Furrah/Bat_detector_FW/bat_detector_circuit.pdf

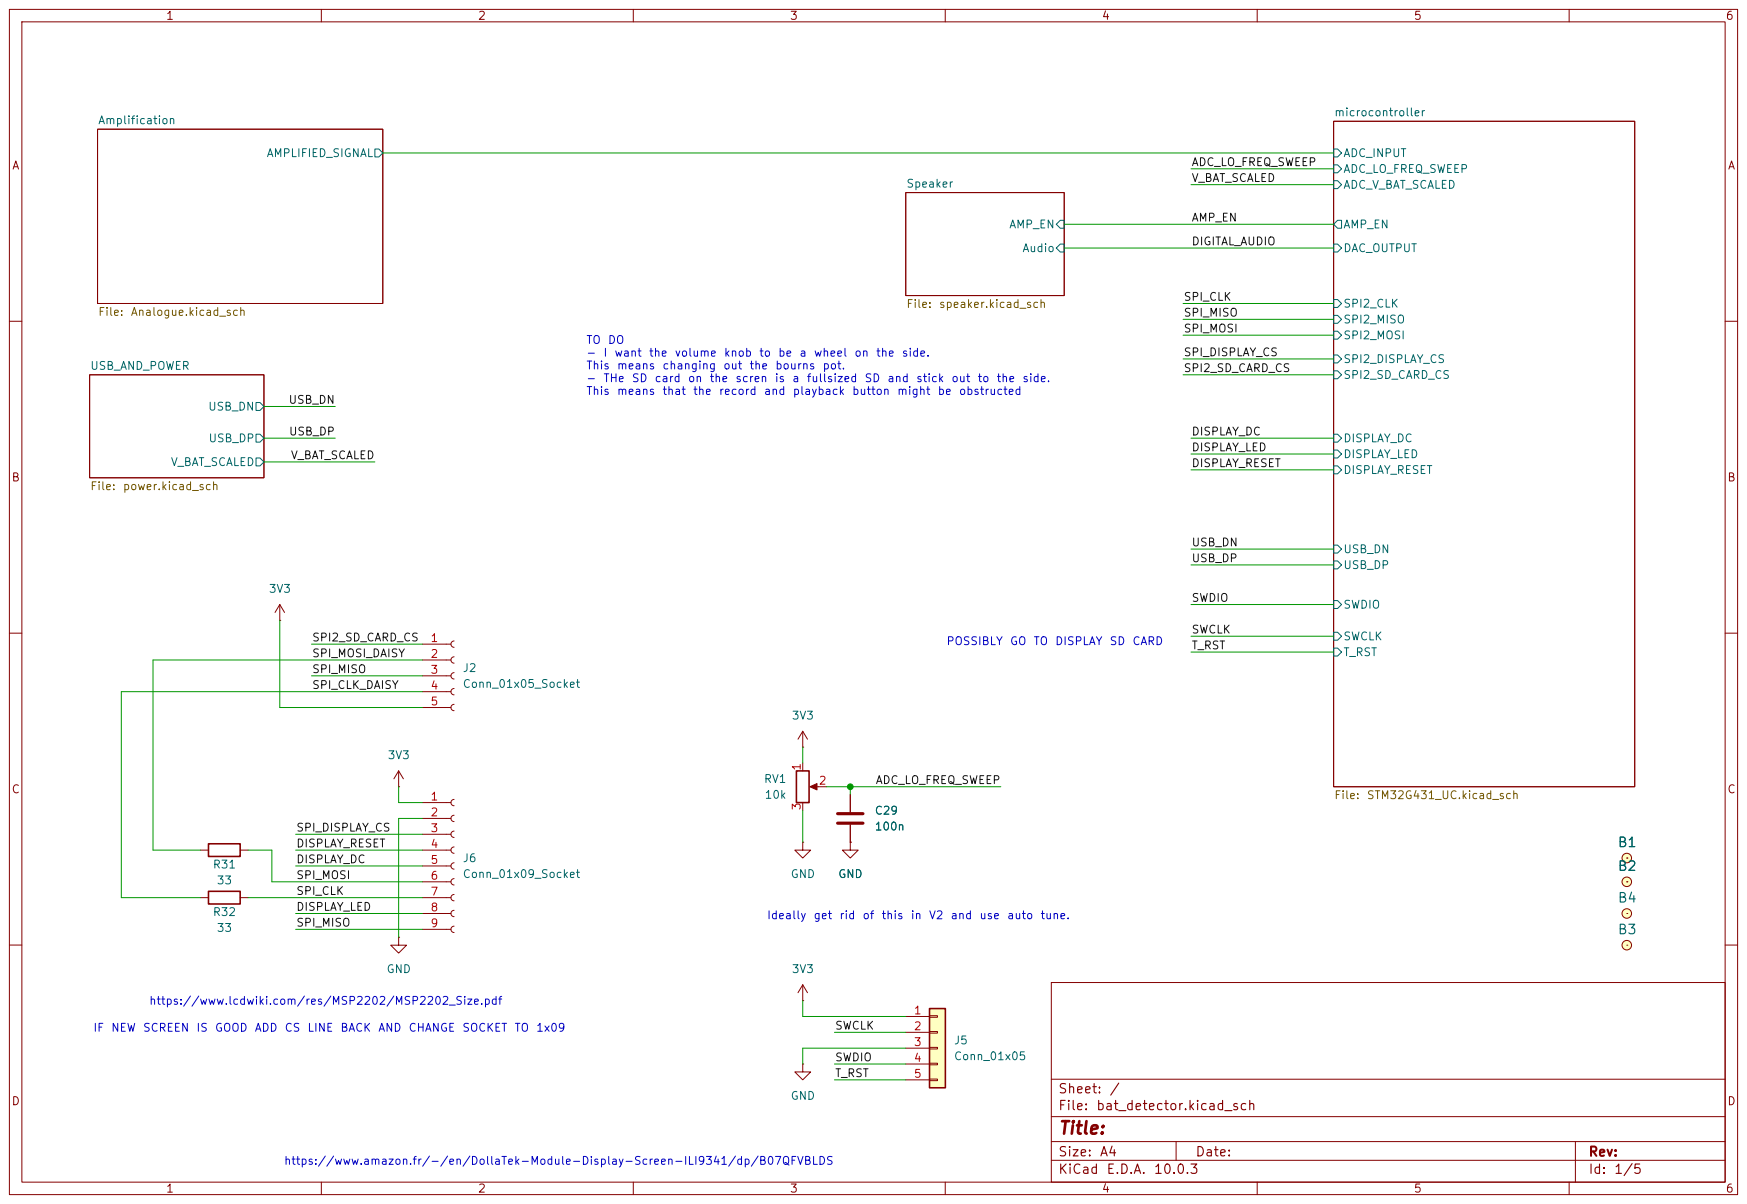
[picture p1: page 1]

TO DO - I want the volume knob to be a wheel on the side.

This means changing out the bourns pot. - THe SD card on the scren is a fullsized SD and stick out to the side.

Ideally get rid of this in V2 and use auto tune. POSSIBLY GO TO DISPLAY SD CARD

https://www.lcdwiki.com/res/MSP2202/MSP2202_Size.pdf

IF NEW SCREEN IS GOOD ADD CS LINE BACK AND CHANGE SOCKET TO 1x09

Size: A4 | Rev:
KiCad E.D.A. 10.0.3 | Id: 1/5

https://www.amazon.fr/-/en/DollaTek-Module-Display-Screen-ILI9341/dp/B07QFVBLDS

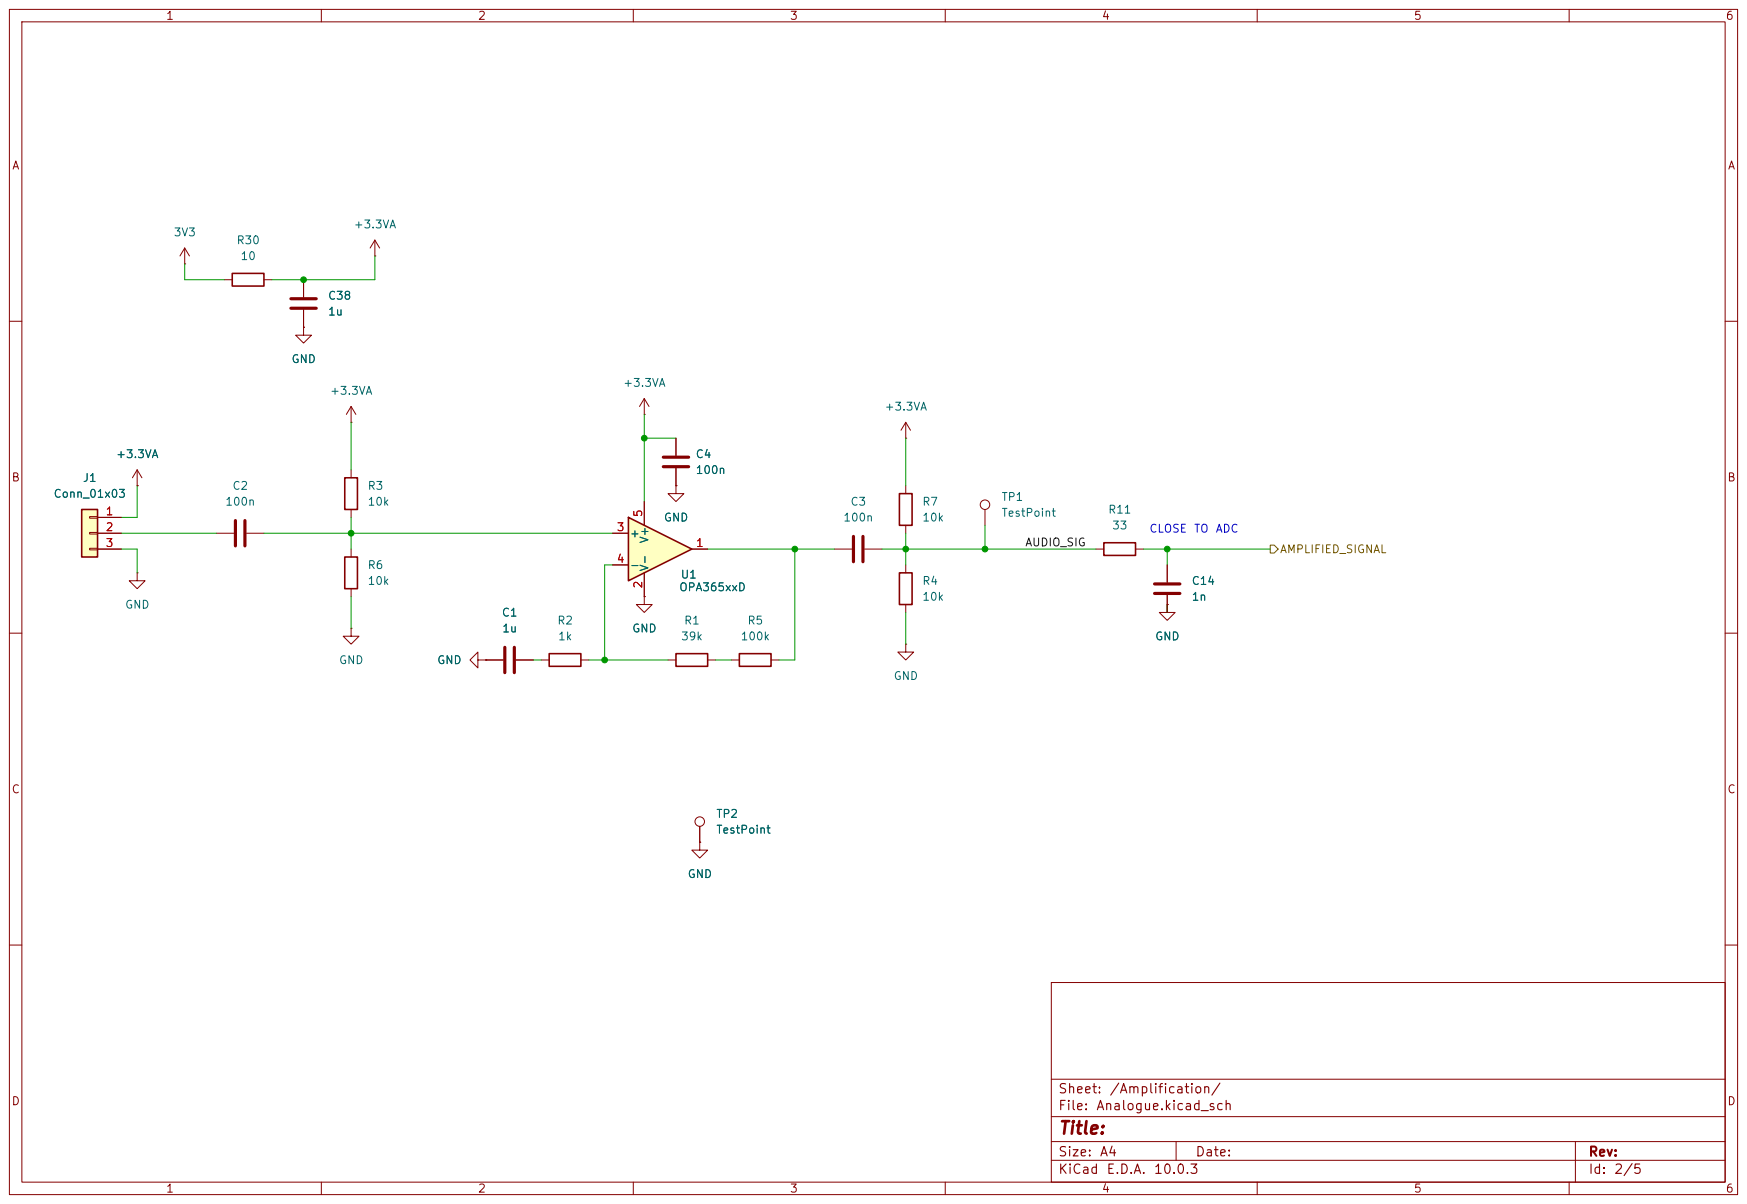
[picture p2: page 2]

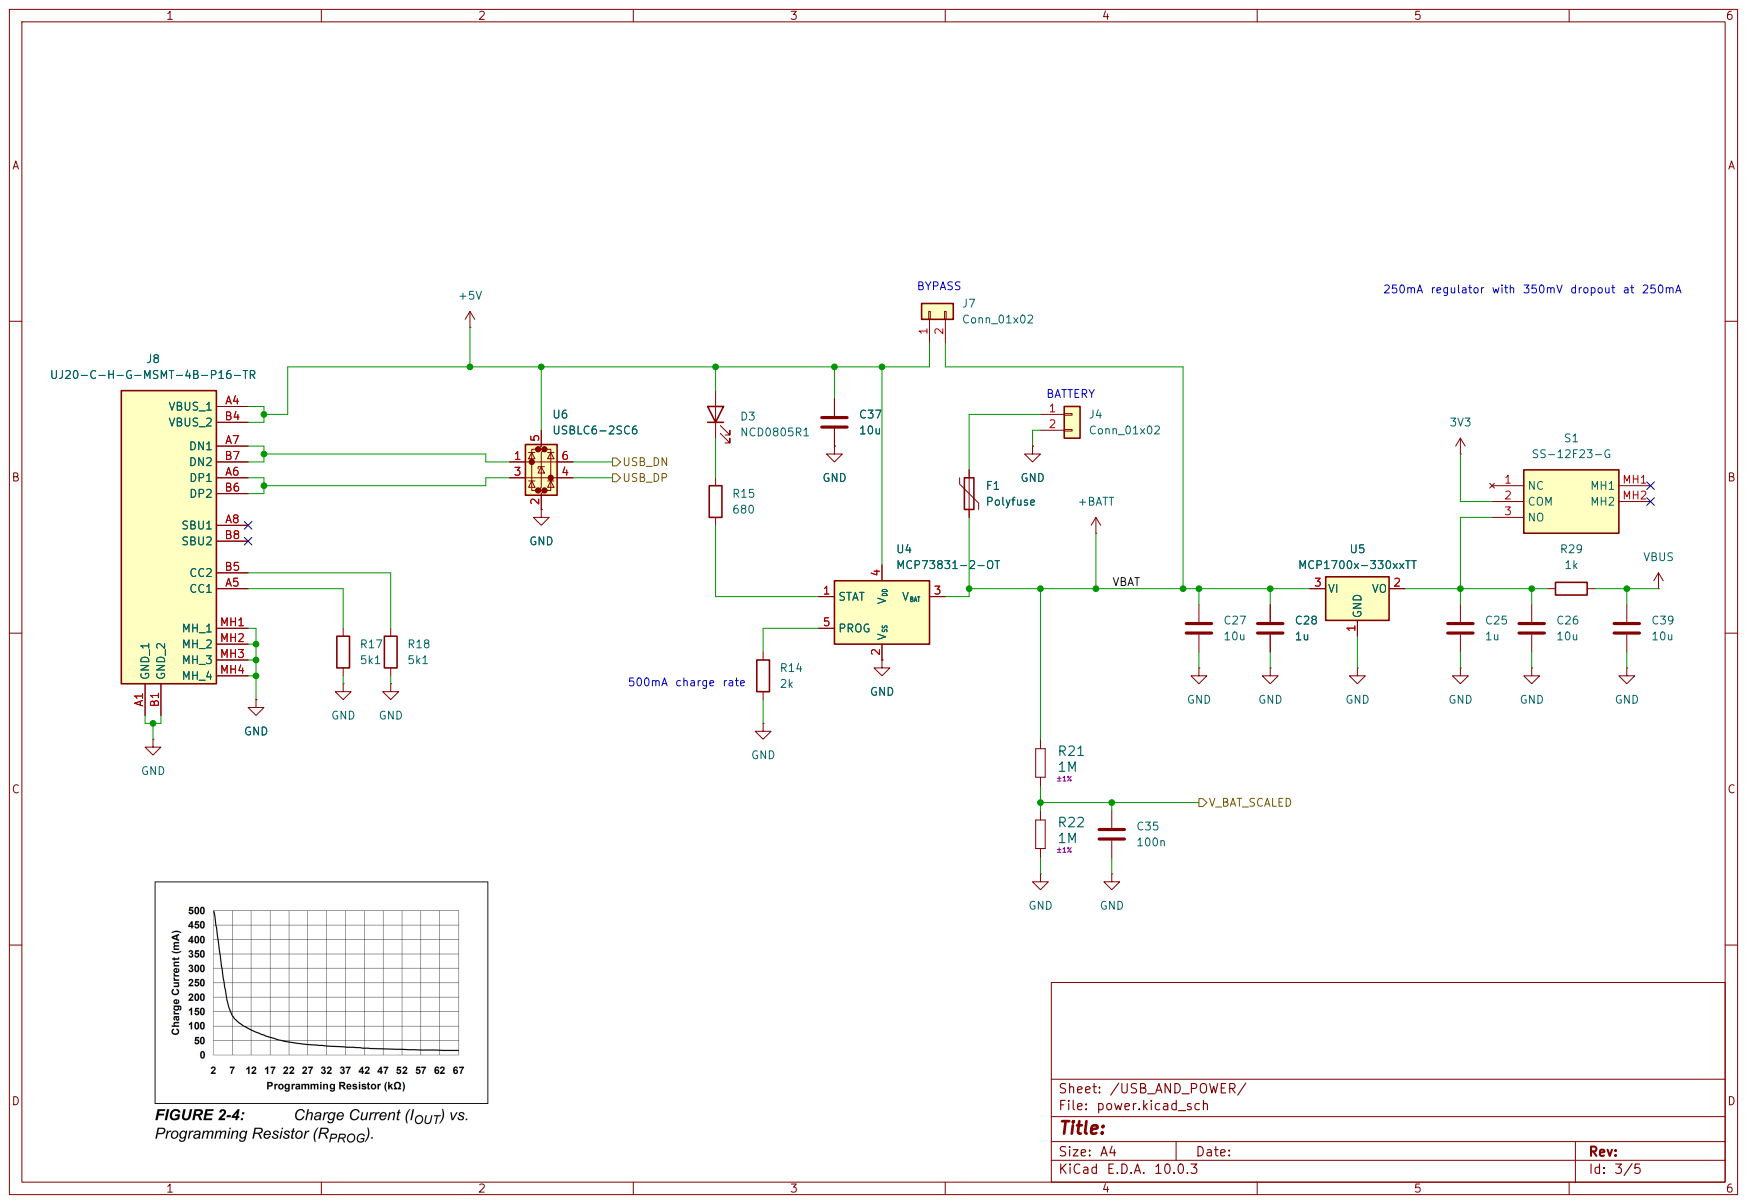
[picture p3: page 3]

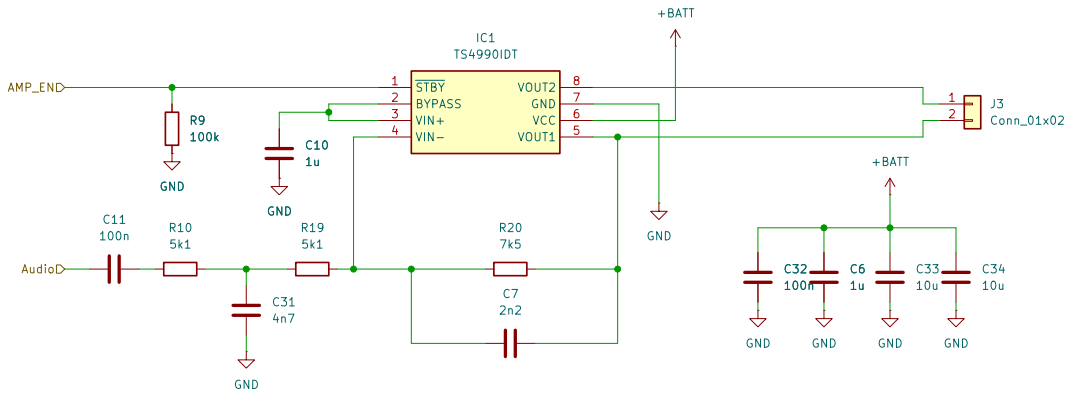
[picture p4: page 4]

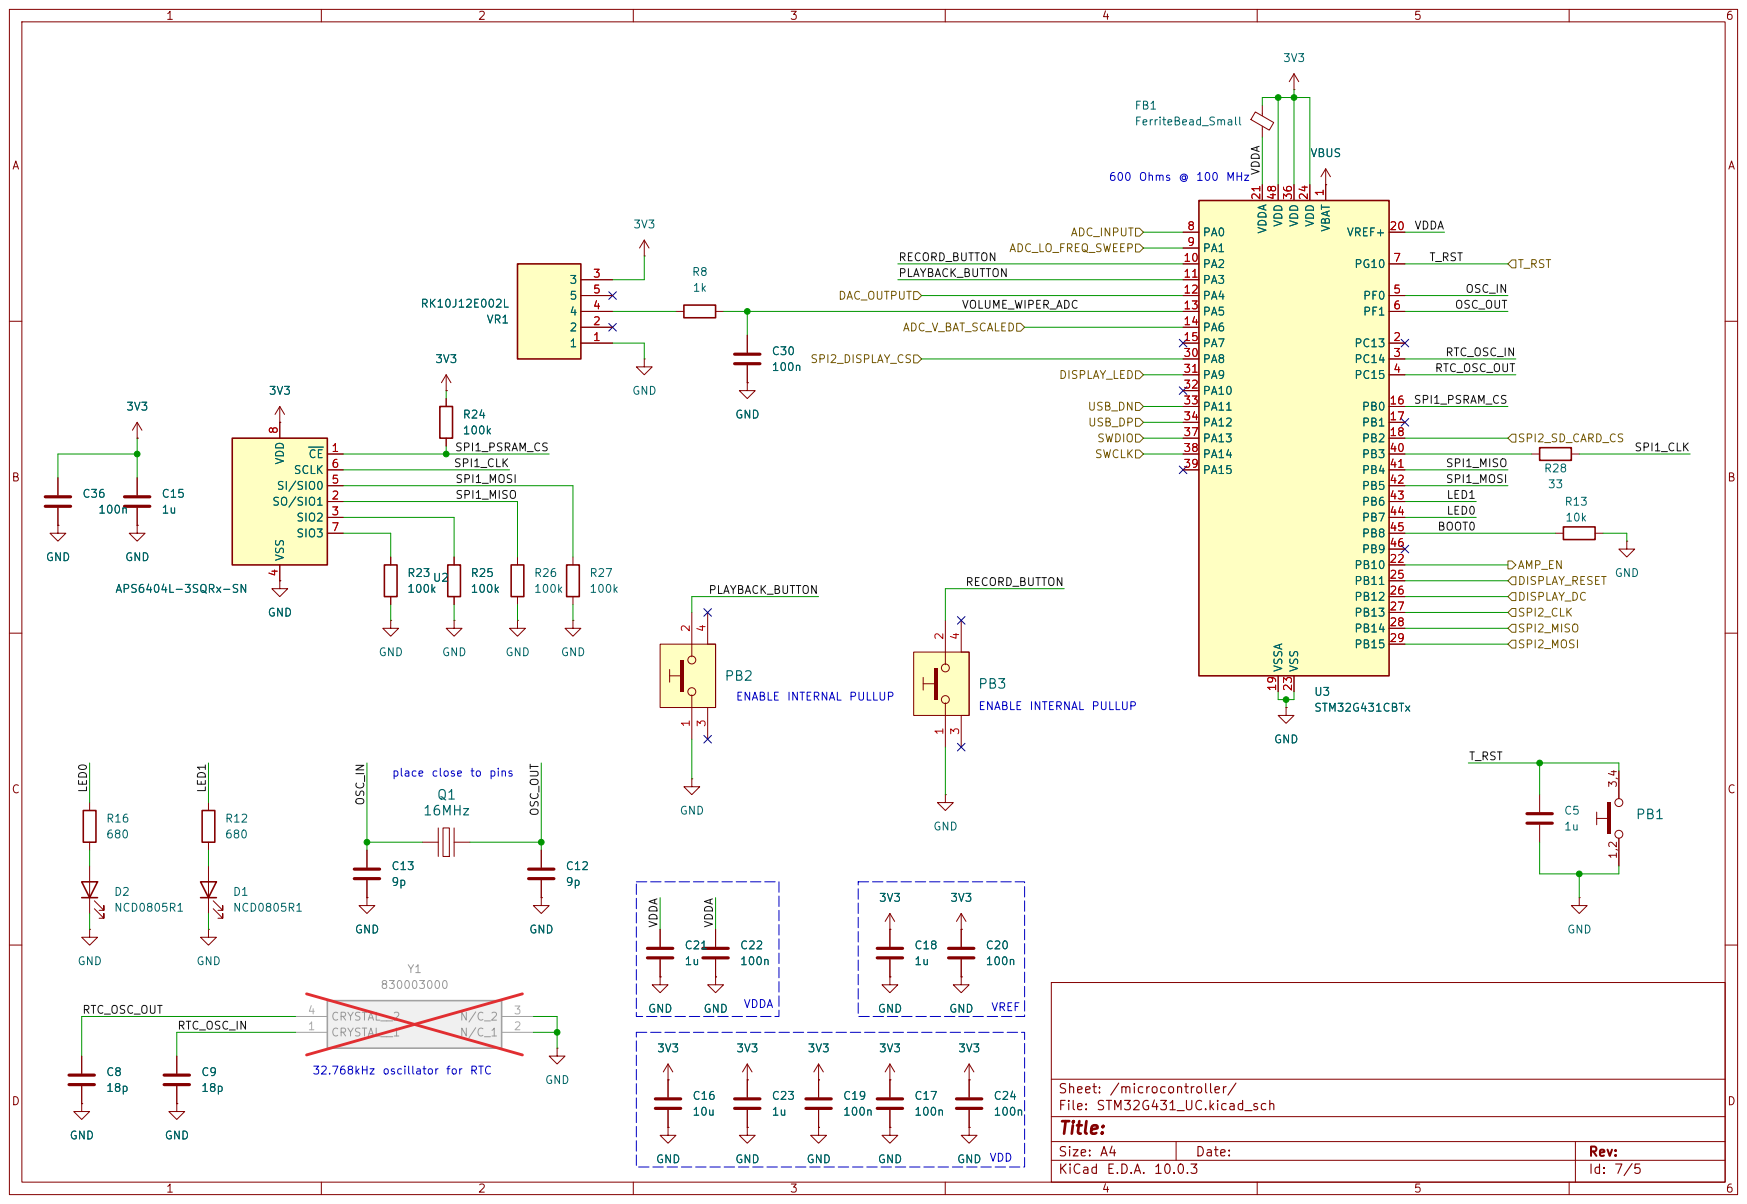
[picture p5: page 5]

ENABLE INTERNAL PULLUP

VDDA 32.768kHz oscillator for RTC
