Furrah/Bat_detector_FW/Core/Src/main.c

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
/* Includes ------------------------------------------------------------------*/
#include "main.h"
#include "app_fatfs.h"
#include "usb_device.h"

/* USER CODE BEGIN Includes */

#include "pipeline_config.h"
#include "adc.h"
#include "autotune.h"
#include "bat_detect.h"
#include "boot_checks.h"
#include "dac.h"
#include "debug_link.h"
#include "dsp.h"
#include "fft.h"
#include "ili9341.h"
#include "recorder.h"
#include "ui.h"
#include "waterfall.h"

/* USER CODE END Includes */

ADC_HandleTypeDef hadc1;
ADC_HandleTypeDef hadc2;
DMA_HandleTypeDef hdma_adc1;
DMA_HandleTypeDef hdma_adc2;

DAC_HandleTypeDef hdac1;
DMA_HandleTypeDef hdma_dac1_ch1;

RTC_HandleTypeDef hrtc;

SPI_HandleTypeDef hspi1;
SPI_HandleTypeDef hspi2;
DMA_HandleTypeDef hdma_spi1_rx;
DMA_HandleTypeDef hdma_spi1_tx;

TIM_HandleTypeDef htim2;

void SystemClock_Config(void);
static void MX_GPIO_Init(void);
static void MX_DMA_Init(void);
static void MX_ADC1_Init(void);
static void MX_DAC1_Init(void);
static void MX_SPI2_Init(void);
static void MX_ADC2_Init(void);
static void MX_TIM2_Init(void);
static void MX_SPI1_Init(void);
static void MX_RTC_Init(void);
/**
  * @brief  The application entry point.
  * @retval int
  */
int main(void)
{

  /* MCU Configuration--------------------------------------------------------*/

  /* Reset of all peripherals, Initializes the Flash interface and the Systick. */
  HAL_Init();

  /* Configure the system clock */
  SystemClock_Config();

  /* USER CODE BEGIN SysInit */

  /* CubeMX writes HSI48CalibrationValue = 32, but the G4's CRS TRIM is 7 bits
   * with 64 as the middle; 32 would start HSI48 ~4-5% slow. TRIM is read-only
   * while auto-trim runs, so pause it to write the value. */
  CLEAR_BIT(CRS->CR, CRS_CR_AUTOTRIMEN);
  MODIFY_REG(CRS->CR, CRS_CR_TRIM, RCC_CRS_HSI48CALIBRATION_DEFAULT << CRS_CR_TRIM_Pos);
  SET_BIT(CRS->CR, CRS_CR_AUTOTRIMEN);

  /* USER CODE END SysInit */

  /* Initialize all configured peripherals */
  MX_GPIO_Init();
  MX_DMA_Init();
  MX_ADC1_Init();
  MX_DAC1_Init();
  MX_USB_Device_Init();
  MX_SPI2_Init();
  MX_ADC2_Init();
  MX_TIM2_Init();
  MX_SPI1_Init();
  MX_RTC_Init();
  if (MX_FATFS_Init() != APP_OK) {
    Error_Handler();
  }
  /* USER CODE BEGIN 2 */

  // Flush-to-zero on the FPU, so denormal numbers can't slow the biquad filters
  __set_FPSCR(__get_FPSCR() | (1UL << 24));

  ADC_Init();
  DSP_Init();
  BatDetect_Init();
  AutoTune_Init();
  DAC_Init();
  FFT_Init();
  DebugLink_Init();

  // MX_GPIO_Init leaves every SPI chip-select low. Deselect SD and PSRAM
  // before the first SPI2 transfer so the SD card doesn't see display traffic.
  HAL_GPIO_WritePin(SPI2_SD_CARD_CS_GPIO_Port, SPI2_SD_CARD_CS_Pin, GPIO_PIN_SET);
  HAL_GPIO_WritePin(SPI1_PSRAM_CS_GPIO_Port, SPI1_PSRAM_CS_Pin, GPIO_PIN_SET);
  ILI9341_Unselect();
  ILI9341_Init();

  HAL_GPIO_WritePin(DISPLAY_LED_GPIO_Port, DISPLAY_LED_Pin, GPIO_PIN_SET); // backlight on
  ILI9341_FillScreen(ILI9341_BLACK);

  // Power-up checks (boot_checks.h). Hold RECORD for the full 8 MB PSRAM
  // test, PLAYBACK for the SD speed test. A PSRAM that passes starts its
  // ring, which keeps the last 16.8 s of raw audio, before the ADC starts,
  // so ring block 0 is the first block.
  BootChecks_Spi2();
  (void)BootChecks_Psram();
  BootChecks_Sd();

  Waterfall_Init();       // clears the check results off the screen
  Waterfall_SetRange(-10.0f, 20.0f);

  ADC_SetHalfBufferCallback(DSP_ProcessBlock);
  ADC_SetFullBufferCallback(DSP_ProcessBlock);
  DSP_SetOutputCallback(DAC_WriteBlock);

  HAL_TIM_Base_Start(&htim2);
  DAC_Start();
  ADC_Start();

  // TS4990 is held in standby by R9 until AMP_EN goes high. Enable it only
  // once the DAC is already outputting mid-scale, to avoid a turn-on pop.
  HAL_GPIO_WritePin(AMP_EN_GPIO_Port, AMP_EN_Pin, GPIO_PIN_SET);

  /* USER CODE END 2 */

  /* Infinite loop */
  /* USER CODE BEGIN WHILE */

  UI_Init();

  while (1)
  {
    UI_Poll();          // every 10 ms: knobs, buttons, header line, LEDs
    DebugLink_Poll();   // USB debug capture: PC commands, data that's ready
    Recorder_Poll();    // WAV recording, ahead of the FFT: the PSRAM ring holds only 16.8 s
    FFT_Process();
    UI_PollDisplay();   // the waterfall's rows (and auto-tune), the battery readout

    /* USER CODE END WHILE */

    /* USER CODE BEGIN 3 */
  }
  /* USER CODE END 3 */
}

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
