Furrah/Bat_detector_FW/bat_detector.ioc

Mcu.UserName=STM32G431CBTx
PA0.Signal=ADC1_IN1
PA1.Signal=ADC2_IN2
PA11.Signal=USB_DM
PA12.Signal=USB_DP
PA13.Signal=SYS_JTMS-SWDIO
PA14.Signal=SYS_JTCK-SWCLK
PA2.GPIO_Label=RECORD_BUTTON
PA2.Signal=GPIO_Input
PA3.GPIO_Label=PLAYBACK_BUTTON
PA3.Signal=GPIO_Input
PA4.Signal=COMP_DAC11_group
PA5.Signal=ADC2_IN13
PA6.Signal=ADC2_IN3
PA8.GPIO_Label=SPI2_DISPLAY_CS
PA8.Signal=GPIO_Output
PA9.GPIO_Label=DISPLAY_LED
PA9.Signal=GPIO_Output
PB0.GPIO_Label=SPI1_PSRAM_CS
PB0.Signal=GPIO_Output
PB10.GPIO_Label=AMP_EN
PB10.Signal=GPIO_Output
PB11.GPIO_Label=DISPLAY_RESET
PB11.Signal=GPIO_Output
PB12.GPIO_Label=DISPLAY_DC
PB12.Signal=GPIO_Output
PB13.Signal=SPI2_SCK
PB14.Signal=SPI2_MISO
PB15.Signal=SPI2_MOSI
PB2.GPIO_Label=SPI2_SD_CARD_CS
PB2.Signal=GPIO_Output
PB3.Signal=SPI1_SCK
PB4.Signal=SPI1_MISO
PB5.Signal=SPI1_MOSI
PB6.GPIO_Label=LED1
PB6.Signal=GPIO_Output
PB7.GPIO_Label=LED0
PB7.Signal=GPIO_Output
PF0-OSC_IN.Signal=RCC_OSC_IN
PF1-OSC_OUT.Signal=RCC_OSC_OUT
