Furrah/Bat_detector_FW/Core/Drivers/tim3_lo.h

/*
 * tim3_lo.h
 *
 *  Created on: 6 Aug 2026
 *      Author: Joe Spencer
 */

#ifndef DRIVERS_TIM3_LO_H_
#define DRIVERS_TIM3_LO_H_

#include <stdint.h>

void LO_SetFrequency(uint32_t frequency);


#endif /* DRIVERS_TIM3_LO_H_ */
