Furrah/Bat_detector_FW/(commit log)

2026-10-30 V2 board port and PSRAM bring-up
    Port the V1 firmware to the V2 PCB and bring up the APS6404L PSRAM.
    - .ioc regenerated for V2 pins: display CS/RES/DC on PA8/PB11/PB12,
    SD CS on PB2, PSRAM on SPI1 (PB3/4/5, CS PB0), AMP_EN on PB10,
    buttons on PA2/PA3. LSE off (Y1 DNP), RTC from HSE/32.
    - ADC2 3-rank scan (LO pot, volume, V_BAT/2) via DMA1 Ch3, non-blocking
    ADC2_StartScan/ScanReady/Get API; ADC2 calibrated at init.
    - Volume knob applied as square-law digital gain in DSP_ProcessBlock.
    - Battery voltage readout in the waterfall header.
    - AMP_EN driven high after the DAC starts; SD and PSRAM CS deselected
    before the first SPI2 transfer.
    - psram.c: register-level, interrupt-masked SPI1 d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
2026-10-30 250 kHz pipeline, PSRAM timeouts, SD card driver, engineering diary
    Sample rate and pipeline:
    - Core/Inc/pipeline_config.h is the single source for the sample rate
    (exactly 250 kHz: 170 MHz / 680), block size, FFT length and LO limit.
    ADC/DAC/DSP/FFT/waterfall constants are aliases; compile-time checks
    for an integer rate and LO < Nyquist; startup check that the CubeMX
    TIM2 period matches.
    - LO range raised to 120 kHz; LO label fixed at 13 characters so it
    clears the battery readout.
    - DSP load measured with the DWT cycle counter (dspCyclesMax,
    dspLoadMaxPercent). Debug build now -Og: 37% load at 250 kHz
    (101% at -O0), flash 66.8 KB (95.2 KB at -O0). The -Og setting lives
    in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
    [adc.c, adc.h, dac.h, main.c, pipeline_config.h]
2026-10-30 RAM reclaim, bat detector stage 1, USB fix and debug capture
    RAM reclaim (diary 26-29):
    - Lookup tables in flash, generated by Tools/gen_dsp_tables.py into
    Core/DSP/Tables: Hann window, FFT twiddles, FFT unpack rotation, NCO sine
    - The DAC copies each block into the free half of its buffer, chosen
    from the DMA counter; dacQueue removed, dacLateBlocks counts collisions
    - Stack 2 KB. FFT_Process 2.14 ms per frame (was 5.77 ms)
    Bat-call detector, stage 1, monitor only (diary 30):
    - Core/DSP/bat_detect.c: energy above 10 kHz per block against a
    tracked noise floor; 1-100 ms pulses; 2 pulses within 600 ms trigger;
    2 s hold. LED0 = bat present, LED1 = flash per pulse
    USB (diary 31):
    - CR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
    [analyse_capture.py, bat_detector.ioc, capture.py, dac.c, debug_link.c, debug_link.h]
2026-10-30 CubeMX: SPI1 RX/TX DMA on DMA2 for the PSRAM ring
    SPI1_RX on DMA2 Channel 1 and SPI1_TX on DMA2 Channel 2: normal mode,
    byte width, memory increment, very high priority. Generated
    configuration only; nothing uses it yet.
    Still to do before the ring engine runs: NVIC priorities, with DMA2
    Channel 1 alone at 0 and the audio, DAC and USB interrupts at 1, so
    the burst-complete interrupt can always raise CE# within tCEM (8 us).
2026-10-30 PSRAM ring buffer: continuous DMA recording of the raw ADC
    Every 1.024 ms audio block is written to the APS6404L PSRAM by a DMA
    and interrupt driven engine on SPI1 (Core/Drivers/psram_ring.c), so the
    last 16.8 s are always available for time expansion and recording.
    - 16-byte bursts on DMA2 Ch1/Ch2; the burst-complete interrupt (alone at
    priority 0) raises CE# and starts the next burst. CE# max 4.44 us
    against tCEM 8 us, measured on every burst.
    - Burst interrupt runs from RAM (__RAM_FUNC) and the file builds at -O2:
    2.3 us per burst. HAL's DMA handler is skipped.
    - SPI1/SPI2 NSS pulse mode disabled: CubeMX's default put 2 idle clocks
    after every byte and pushed bursts past tCEM.
    -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
    [adc.c, bat_detector.ioc, capture.py, debug_link.c, debug_link.h, main.c, psram_ring.c, psram_ring.h]
2026-10-30 Time-expansion playback from the PSRAM ring
    The PLAYBACK button replays the last 2 s of raw audio from the PSRAM
    ring 10x slower (20 s), so a 45 kHz call plays at 4.5 kHz with its
    shape, harmonics and rhythm intact. Press again to stop.
    - Core/DSP/playback.c: the recording goes through the same 10 kHz
    high-pass as the heterodyne, then linear interpolation at the full
    250 kHz DAC rate. Two block slots: one plays while the next loads.
    - Replaces the heterodyne output while active; the detector, debug
    capture and waterfall stay on the live input.
    - The ring pauses recording during playback so the segment can't be
    overwritten, and resumes afterwards. Stuck-burst detection now runs
    on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
    [debug_link.c, main.c, pipeline_config.h, psram_ring.c, psram_ring.h]
2026-10-31 Blog series: the project told as 11 topic posts
    Docs/blog/ rewrites the engineering diary as a story, one post per topic:
    introduction, ADC/DAC, DMA, DSP, FFT and waterfall, V2 bring-up, PSRAM
    bring-up, the PSRAM ring buffer, time expansion, the bat detector and USB
    debug link, and lessons/next steps. First person, for readers past
    Arduino level. Facts checked against the code and the V1 commit cd8940b.
    Places that need the author's own history are marked "TODO (you)".
    The engineering diary stays as the decision log.
2026-10-31 CLAUDE.md: describe the DSP chain as the code implements it
    The old line said "NCO -> multiply -> decimate -> DAC". There is no
    decimation: the output runs at the full 250 kHz. List the actual chain
    (high-pass, gain, NCO mixer, two low-passes, volume, clamp), the
    inter-stage int32 truncation, the detector/FFT/debug-link taps, and what
    playback skips.
2026-11-02 SD bring-up: card format rules and first measurements (diary 38)
    A 16 GB SDHC card formatted FAT32 with SD Card Formatter mounts, and the
    boot speed test reads back correctly (W666 R648 kB/s, single-sector).
    A PC check of SDTEST.BIN matches the pattern byte for byte.
    The 1.33x headroom over 500 kB/s was measured with nothing else running,
    so the recorder's write size is left to a sustained test under load.
2026-11-02 SD recording path verified under load; stats readout; faster FFT
    SD card (diary 38-40):
    - sd_bench.c + capture.py sdtest: copies the PSRAM ring's live audio to
    the card for a set time with everything else running, N sectors per
    write, polled or DMA, and reports headroom, backlog, stalls and FFT
    cost. 8-sector polled writes keep up: 1.38x while catching up a 5 s
    pre-trigger, 1.93x once caught up, 92.6 MB verified on the PC
    (Tools/check_raw.py).
    - sd_spi.c: data blocks polled by default. SPI2 DMA (register-level,
    DMA1 Ch4/Ch5; CubeMX setup added) kept behind sdUseDma, off: with it
    the card occasionally misses a block's start token.
    - Recovery: a failed read or write re-initialise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
    [adc.h, bat_detector.ioc, capture.py, check_raw.py, dac.h, debug_link.c, debug_link.h]
2026-11-02 Diary 39-40 and CLAUDE.md: SD writes, the FFT at -O2, DMA dropped
    Entry 39: single-sector writes can't keep up under recording load; 8-sector
    multi-block writes can; the FFT at -O2; CMSIS-DSP rejected.
    Entry 40: SPI2 DMA tried (HAL, then register-level) and dropped over a
    missed-start-token fault; recovery added; data verified on the PC.
2026-11-03 WAV recording to SD on RECORD; internal pull-up on SD MISO
    RECORD writes the PSRAM ring's last 5 s plus the live stream to
    BATnnnnn.WAV (mono 16-bit PCM, 250 kHz) until pressed again or 600 s.
    The 512-byte header keeps the audio sector-aligned, so every write is one
    8-sector CMD25. Every 2 s the file is synced and its header rewritten in
    place, so a power cut loses at most 2 s. The recorder borrows the debug
    link's 8 KB buffer; the ring reports where it resumed after a playback so
    a pre-trigger never spans one.
    PB14 (SD MISO) gets the internal pull-up: a missing card floated MISO low
    and read as a busy card (500 ms timeout) instead of "no card".
    check_raw.py reads the recorder's WAVs; capt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
    [bat_detector.ioc, capture.py, check_raw.py, debug_link.c, debug_link.h, main.c, psram_ring.c, psram_ring.h]
2026-11-03 Diary 41-43, CLAUDE.md; species classifier modelled on the PC, deferred
    Diary 41 (WAV recorder) and 42 (SD MISO pull-up) with their hardware
    results; 43: the species classifier is parked on the device. It needs
    ~3.6 KB of RAM against 848 B free and an estimated 23-44% of the CPU,
    and there is no bat data to fit its rules until spring.
    Tools/classify.py models its stages 1-3 at 250 kHz (128-point FFT,
    64-sample hop) and runs on any WAV. Tools/bat_signals.py synthesises the
    design's bench signals in the board's measured noise; --selftest passes.
    Five changes from the design were needed, listed in diary 43: with the
    design's thresholds, plain noise gave 29,000 false calls a minute.
    Adds the c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
    [bat_signals.py, classify.py]
2026-11-03 Track the build files, so a clone of the repo builds
    The repo held the application code but not what CubeIDE needs to build
    it: .project and .cproject (including the extra include paths for
    Core/DSP, Core/Display, Core/Drivers and main.c's own list), the
    CubeMX-generated USB device files, the STM32G4 HAL driver, and the USB
    device and FatFs middlewares. They were all gitignored, so a fresh clone
    couldn't build and regenerating in CubeMX wouldn't restore the include
    paths.
    Only the two prebuilt CMSIS-DSP libraries (11 MB) stay ignored: nothing
    links them. .cproject loses a stale absolute include path to a folder
    that no longer exists (Core/Ili9341, Release configuration).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
2026-11-03 Auto-tune with manual/auto modes on a long PLAYBACK press; calmer detector LEDs
    Auto-tune (Core/DSP/autotune.c, diary 45) points the heterodyne LO at
    the bats being heard. It reads the waterfall's 40 ms rows, learns a noise
    floor per column between passes (so steady tones never win), and during
    a pass sets the LO 1.5 kHz below the median of the last 8 calls' loudest
    frequency; it moves only for more than 2 kHz, at most once a second.
    Holding PLAYBACK for 0.8 s switches between manual (the knob) and auto
    (the knob is ignored); a short press still plays back, on release.
    Modelled on synthetic calls first; works on the bench with a 40 kHz
    transducer (locked to 39.6 kHz). Field accuracy still to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
    [analyse_capture.py, debug_link.c, main.c, waterfall.c]
2026-11-03 Clean-up 1: unused modules archived, SD DMA path and TIM3 calls removed
    Archive/ holds files that are no longer built (Archive/README.md says
    why): the SD write test (sd_bench, its job done in diary 38-40; its PC
    side, capture.py sdtest, is removed too), V1's TIM3 LO, the V1 touch
    driver, and an AGC that was never connected. Nothing is deleted.
    The SD driver's register-level DMA path, off since diary 40, is removed;
    the driver is all polled HAL. TIM3 is no longer started or retuned (it
    has no output pin on V2); MX_TIM3_Init goes when TIM3 is unticked in
    CubeMX. Also: commented-out code removed, and DAC_Start stops in
    Error_Handler if the DAC won't start (the build's last warning).
    No chang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
    [adc.c, capture.py, check_raw.py, dac.c, debug_link.c, debug_link.h]
2026-11-03 Clean-up 1b: TIM3, SPI2 DMA and the unused CMSIS-DSP packs removed in CubeMX
    TIM3 (V1's LO, no output pin on V2) and SPI2's DMA channels (DMA1 Ch4/Ch5,
    unused since the SD driver's DMA path went) are removed in CubeMX, so
    their generated init, handles and interrupt handlers go.
    The two software packs that brought in the prebuilt CMSIS-DSP library
    (X-CUBE-ALGOBUILD, FP-SNS-STAIOTCFT) are detached from the .ioc, and
    CubeIDE's stored CubeMX defaults in .cproject no longer list the
    library. Unticking the packs' components had not been enough: every
    Generate Code put the library back into the linker settings, which
    breaks a fresh clone's link. Checked: after Generate Code both files
    stay clean.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
    [bat_detector.ioc, main.c]
2026-11-03 Clean-up 2a: Core/Diag library, cycle timing and failure records
    Core/Diag starts a self-contained diagnostics library meant to be copied
    into other STM32 projects (README.md says how):
    diag_port.h the device header, the one line to change per project
    diag_cycles.h the DWT cycle counter: start, read, convert to us/ns,
    keep a worst case, best case or running average
    diag_error.h failure records: a count and the first failure's
    details packed in one word
    All inline (DIAG_INLINE forces it), so safe in RAM-resident interrupts.
    Six modules' hand-rolled DWT code moves onto it: the DSP load (adc.c),
    FFT timing, the recorder's write and sync times, the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
    [adc.c, diag_cycles.h, diag_error.h, diag_port.h, psram.c, psram_ring.c, recorder.c]
2026-11-03 Clean-up 2b: SPI and interrupt checks in Core/Diag; honest timing resets
    diag_spi.h/.c checks what CubeMX actually generated: an SPI's frame
    size and NSS pulse mode, pins slower than a given speed, and an
    interrupt alone at the top priority; plus a receive-FIFO drain. The
    PSRAM ring's start-up checks use them (and now include pin speed), SPI2
    (display and SD) gets the same checks at boot, and the SD driver's
    stale-byte check uses the drain.
    The ring's timing reset ('Z', stats --window) now runs at the end of the
    burst interrupt, after its own time is taken. It used to run inside the
    timed section, so the first burst after a reset recorded the reset's
    own work: the window read 2.52-2.59 us;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
    [diag_spi.c, diag_spi.h, main.c, psram_ring.c, psram_ring.h]
2026-11-03 Clean-up 2c + 3: diag_link and diag_stats; main.c split into ui.c and boot_checks.c
    The USB debug link's generic half moves into Core/Diag: diag_link.c
    (20-byte framed replies with a CRC-32, a command queue fed from the
    receive interrupt, frames sent in place, 'N'/'T'/'Z' for a stats table)
    over a transport the project supplies, and diag_stats.c (the 32-byte
    named-counter entries). The wire format is unchanged. debug_link.c keeps
    this project's captures (I, R, E, S, M, F), the 8 KB buffer and the USB
    transport (814 -> 550 lines); the counters move to stats_table.c, written
    with DIAG_STAT_U32(var). Tools/diaglink.py is the PC side; capture.py
    uses it.
    main.c's user code shrinks to start-up a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
2026-11-03 Diary 46 and CLAUDE.md: the clean-up
    Diary 46 records the clean-up: what moved where, the lost inlining in the
    PSRAM burst interrupt, the timing-reset artefact, why CubeMX kept bringing
    the DSP library back, the costs, and the lessons. CLAUDE.md describes the
    new code layout (ui.c, boot_checks.c, Core/Diag, stats_table.c), the
    ring's forced-inline helpers and start-up checks, and the SPI2 boot check.
